sebastianbeyer/KOSMO_haltingproblem/KosmoTuringJack/TuringJack.kicad_pcb

## KiCad design KosmoTuringJack/TuringJack.kicad_pcb (2022-09-26)

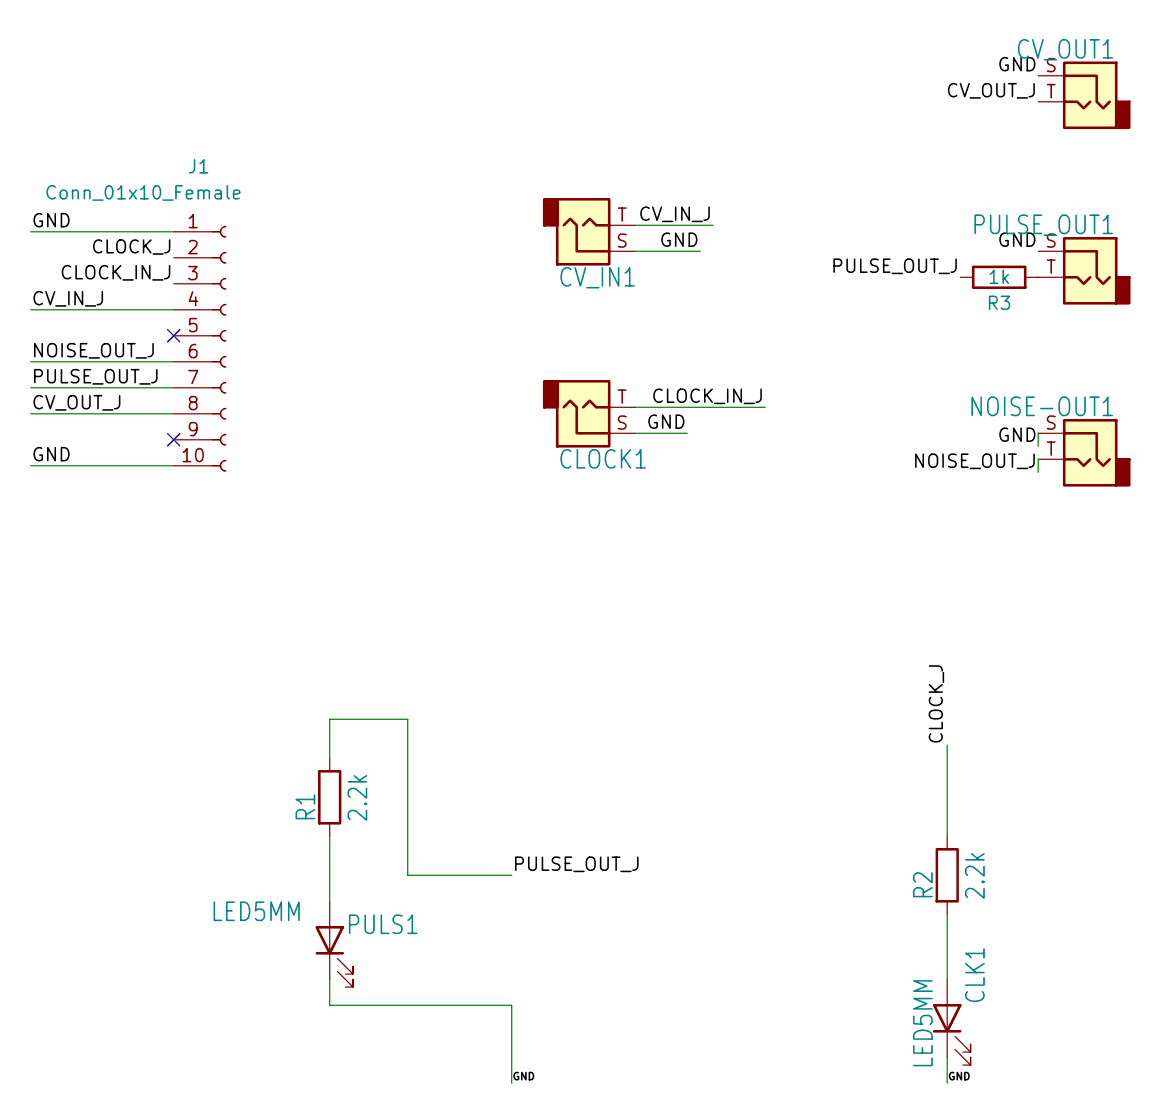
[picture p1: schematic TuringJack.kicad_sch]

Parts:
CLK1: LED5MM; LED_D5.0mm
CLOCK1: THONKICONNNEW; Jack_6.35mm_PJ_629HAN
CV_IN1: THONKICONNNEW; Jack_6.35mm_PJ_629HAN
CV_OUT1: THONKICONNNEW; Jack_6.35mm_PJ_629HAN
J1: Conn_01x10_Female; PinSocket_1x10_P2.54mm_Vertical
NOISE-OUT1: THONKICONNNEW; Jack_6.35mm_PJ_629HAN
PULS1: LED5MM; LED_D5.0mm
PULSE_OUT1: THONKICONNNEW; Jack_6.35mm_PJ_629HAN
R1, R2: 2.2k; R_Axial_DIN0207_L6.3mm_D2.5mm_P10.16mm_Horizontal
R3: 1k; R_Axial_DIN0207_L6.3mm_D2.5mm_P10.16mm_Horizontal

Connections:
/CLOCK_IN_J: CLOCK1.T, J1.3
/CLOCK_J: J1.2, R2.1
/CV_IN_J: CV_IN1.T, J1.4
/CV_OUT_J: CV_OUT1.T, J1.8
/GND: CLK1.1 (K), CLOCK1.S, CV_IN1.S, CV_OUT1.S, J1.1, J1.10, NOISE-OUT1.S, PULS1.1 (K), PULSE_OUT1.S
/NOISE_OUT_J: J1.6, NOISE-OUT1.T
/PULSE_OUT_J: J1.7, R1.1, R3.1
unnamed: CLK1.2 (A), R2.2
unnamed: PULS1.2 (A), R1.2
unnamed: PULSE_OUT1.T, R3.2

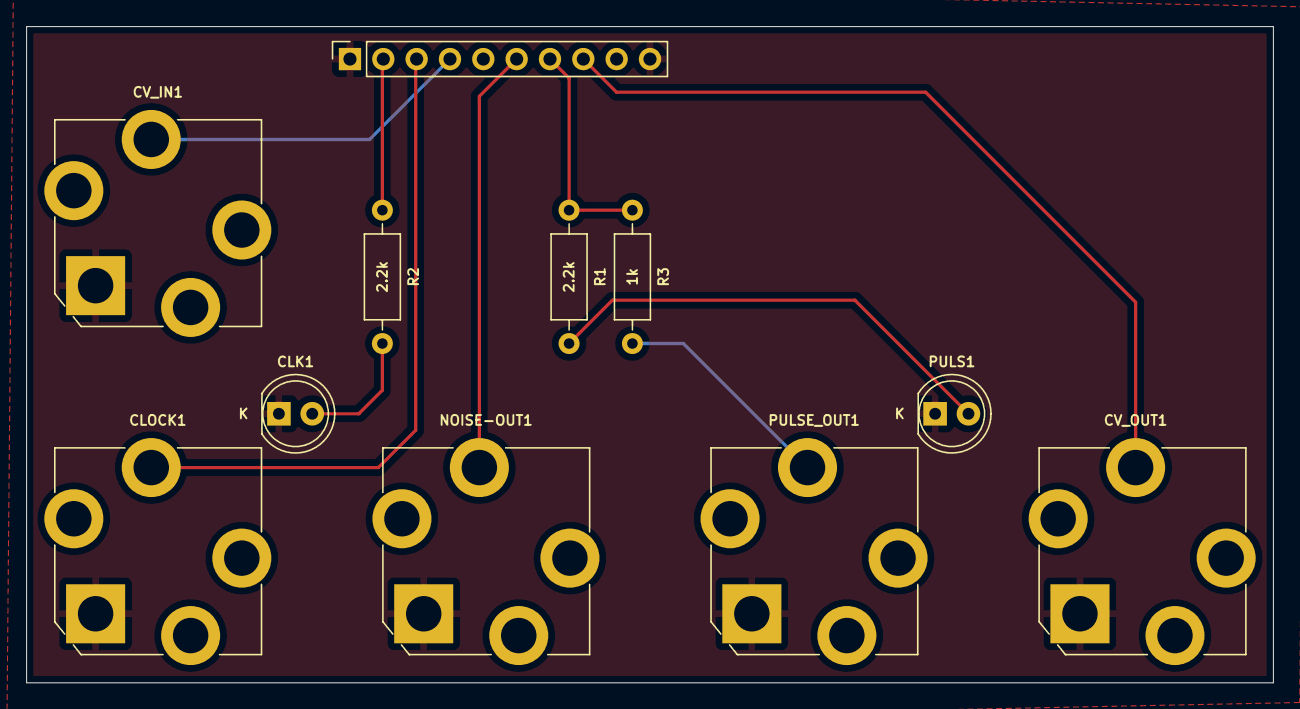
[picture p2: board TuringJack.kicad_pcb from above]

Board: 2 copper layers, 95.0 x 50.0 mm, 11 parts (0 on the bottom side), 10 nets.
