sebastianbeyer/KOSMO_haltingproblem/KosmoTuringMain/TuringMain.kicad_pcb

## KiCad design KosmoTuringMain/TuringMain.kicad_pcb (2022-09-26)

Schematic: TuringMain.kicad_sch

Parts:
AND_1, AND_2: 4081; DIL14
BUFFER1, BUFFER2: 4050; DIL16
C1, C5, C6, C7, C8, C13: 1n; C050-024X044
C2: 10n; C050-024X044
C3, C4, C15, C16, C17, C18, C19, C20, C21, C23, C24, C25, C26: 100n; C_Disc_D3.0mm_W1.6mm_P2.50mm
C9, C10, C12: 0.47uf; C050-035X075
C11: 330pf; C050-024X044
C14: 100n; C050-024X044
C22, C27: 10uf; CP_Radial_D6.3mm_P2.50mm
CHANGE1: 50k; Potentiometer_Alpha_RD901F-40-00D_Single_Vertical_centered
CLOCK1: THONKICONNNEW; Jack_6.35mm_PJ_629HAN
CV_IN1: THONKICONNNEW; Jack_6.35mm_PJ_629HAN
CV_OUT1: THONKICONNNEW; Jack_6.35mm_PJ_629HAN
D1: 1N4148; DO35-7
GATES1: MA08-2; IDC-Header_2x08_P2.54mm_Vertical
IC1: TL072P; DIL08
IC2, IC3: 78L09; TO-92_Inline_Wide
J1: Conn_01x10_Female; PinSocket_1x10_P2.54mm_Vertical
J2: Conn_01x10_Male; PinHeader_1x10_P2.54mm_Vertical
L1, L2: BL01RN1A
LENGTH1: ALPS-SRBV
NOISE-OUT1: THONKICONNNEW; Jack_6.35mm_PJ_629HAN
PULSES1: MA08-2; IDC-Header_2x08_P2.54mm_Vertical
PULSE_OUT1: THONKICONNNEW; Jack_6.35mm_PJ_629HAN
R1, R6, R7, R8, R12, R13, R14, R17, R23, R27: 10k; R_Axial_DIN0207_L6.3mm_D2.5mm_P10.16mm_Horizontal
R2: 3.3k; R_Axial_DIN0207_L6.3mm_D2.5mm_P10.16mm_Horizontal
R3, R5, R21, R24, R25: 100k; R_Axial_DIN0207_L6.3mm_D2.5mm_P10.16mm_Horizontal
R4, R9: 1.6k; R_Axial_DIN0207_L6.3mm_D2.5mm_P10.16mm_Horizontal
R10: 51k; R_Axial_DIN0207_L6.3mm_D2.5mm_P10.16mm_Horizontal
R11: 47k; R_Axial_DIN0207_L6.3mm_D2.5mm_P10.16mm_Horizontal
R15, R22, R26, R30: 1k; R_Axial_DIN0207_L6.3mm_D2.5mm_P10.16mm_Horizontal
R16: 5.1k; R_Axial_DIN0207_L6.3mm_D2.5mm_P10.16mm_Horizontal
R18: 68k; R_Axial_DIN0207_L6.3mm_D2.5mm_P10.16mm_Horizontal
R19, R29: 470k; R_Axial_DIN0207_L6.3mm_D2.5mm_P10.16mm_Horizontal
R20, R28: 15k; R_Axial_DIN0207_L6.3mm_D2.5mm_P10.16mm_Horizontal
R31, R32, R33, R34, R35, R36, R37, R38: 2.2k; R_Axial_DIN0207_L6.3mm_D2.5mm_P10.16mm_Horizontal
SCALE1: 50k; Potentiometer_Alpha_RD901F-40-00D_Single_Vertical_centered
SHIFTREG_EXT1: 4015; DIL16
SHIFTREG_MAIN1: 4015; DIL16
SV1: 10_PIN_HEADER; Power_Header
SWITCH_IC1: 4016; DIL14
T1: 2N3904; TO-92_Inline_Wide
TL1: TL431CLP; TO-92_Inline_Wide
U1: TL074_; DIL14
U$1: DAC0800; DIL16
UNK1, UNK2, UNK3, UNK4, UNK5, UNK6, UNK7, UNK8: LED5MM; LED_D5.0mm
VR1: 1M; Potentiometer_Bourns_3296W_Vertical_screw_centered
WRITE1: T-80-T-SPDT-ON-OFF-ON; SPDT-toggle-switch-1M-series

Connections:
/+12V: AND_1.14 (VDD), AND_2.14 (VDD), C3.2, C15.2, C16.1, C17.1, C18.1, C19.1, C20.1, C21.2, C22.1, GATES1.15, GATES1.16, IC1.8 (V+), IC2.3 (VI), IC3.3 (VI), L1.2, PULSES1.15, PULSES1.16, R1.2, R2.1, R7.2, R12.2, R18.1, R21.1, SHIFTREG_EXT1.16 (VDD), SHIFTREG_MAIN1.16 (VDD), SWITCH_IC1.14 (VDD), U1.4 (V+), U$1.13 (V+), WRITE1.1 (O)
/+12V_INLET: L1.1, SV1.9 (+12V), SV1.10 (+12V)
/-12V: C2.2, C4.2, C25.1, C26.2, C27.2, GATES1.11, GATES1.12, IC1.4 (V-), L2.2, PULSES1.11, PULSES1.12, R6.2, U1.11 (V-), U$1.3 (V-)
/-12V_INLET: L2.1, SV1.1 (-12V), SV1.2 (-12V)
/B1: AND_1.1 (I0), BUFFER1.9 (I), LENGTH1.F (6), R14.1, SHIFTREG_MAIN1.2 (QD), U$1.5 (B1-MSB), UNK8.2 (A)
/B2: AND_1.12 (I0), BUFFER1.11 (I), SHIFTREG_MAIN1.11 (QC), U$1.6 (B2), UNK4.2 (A)
/B3: AND_1.5 (I0), BUFFER1.7 (I), LENGTH1.E (5), SHIFTREG_MAIN1.12 (QB), U$1.7 (B3), UNK7.2 (A)
/B4: AND_1.8 (I0), BUFFER1.5 (I), LENGTH1.D (4), SHIFTREG_MAIN1.13 (QA), U$1.8 (B4), UNK3.2 (A)
/B5: AND_2.12 (I0), BUFFER2.11 (I), LENGTH1.C (3), R8.1, SHIFTREG_MAIN1.10 (QD), U$1.9 (B5), UNK6.2 (A)
/B6: AND_2.8 (I0), BUFFER2.9 (I), LENGTH1.B (2), SHIFTREG_MAIN1.3 (QC), U$1.10 (B6), UNK2.2 (A)
/B7: AND_2.5 (I0), BUFFER2.7 (I), LENGTH1.A (1), SHIFTREG_MAIN1.4 (QB), U$1.11 (B7), UNK5.2 (A)
/B8: AND_2.1 (I0), BUFFER2.5 (I), SHIFTREG_MAIN1.5 (QA), U$1.12 (B8-LSB), UNK1.2 (A)
/BUFFCLK: AND_1.2 (I1), AND_1.6 (I1), AND_1.9 (I1), AND_1.13 (I1), BUFFER2.2 (O), PULSES1.9, PULSES1.10
/BUFFCLK2: AND_2.2 (I1), AND_2.6 (I1), AND_2.9 (I1), AND_2.13 (I1), BUFFER1.2 (O), GATES1.9, GATES1.10
/CLOCK: BUFFER1.3 (I), BUFFER2.3 (I), D1.C, J2.2, R19.1, R27.1, SHIFTREG_EXT1.1 (CLK), SHIFTREG_EXT1.9 (CLK), SHIFTREG_MAIN1.1 (CLK), SHIFTREG_MAIN1.9 (CLK)
/CLOCK_IN: J2.3, R20.1
/CV_IN: J2.4, R10.1
/CV_OUT: CV_OUT1.T, J2.8, R15.1
/END_OF_LOOP: LENGTH1.COM (A), LENGTH1.COM2 (A), SWITCH_IC1.1 (A), SWITCH_IC1.5 (C)
/GATE1: BUFFER2.4 (O), GATES1.1
/GATE2: BUFFER2.6 (O), GATES1.2
/GATE3: BUFFER2.10 (O), GATES1.3
/GATE4: BUFFER2.12 (O), GATES1.4
/GATE5: BUFFER1.4 (O), GATES1.5
/GATE6: BUFFER1.6 (O), GATES1.6
/GATE7: BUFFER1.12 (O), GATES1.7
/GATE8: BUFFER1.10 (O), GATES1.8
/LOOP_CTRL: IC1.2 (-IN), R3.2, R10.2, R11.1
/NOISE: C9.2, IC1.5 (+IN), R24.2, R26.2
/NOISE_OUT: J2.6, R26.1
/PULSE1: AND_2.3 (O), BUFFER1.14 (I), PULSES1.1
/PULSE2: AND_2.4 (O), PULSES1.2
/PULSE3: AND_2.10 (O), PULSES1.3
/PULSE4: AND_2.11 (O), PULSES1.4
/PULSE5: AND_1.10 (O), PULSES1.5
/PULSE6: AND_1.4 (O), PULSES1.6
/PULSE7: AND_1.11 (O), PULSES1.7
/PULSE8: AND_1.3 (O), PULSES1.8
/PULSE_OUT: BUFFER1.15 (O), J2.7
/START_OF_LOOP: C5.2, R13.1, R30.2, SHIFTREG_MAIN1.7 (D)
/STEP_12: C8.2, LENGTH1.G (7), R17.2, SHIFTREG_EXT1.15 (D)
/STEP_16: LENGTH1.H (8), SHIFTREG_EXT1.2 (QD)
GND: AND_1.7 (VSS), AND_2.7 (VSS), BUFFER1.8 (VSS), BUFFER2.8 (VSS), BUFFER2.14 (I), C1.1, C3.1, C4.1, C5.1, C6.1, C8.1, C11.1, C14.1, C15.1, C16.2, C17.2, C18.2, C19.2, C20.2, C21.1, C22.2, C23.1, C24.1, C25.2, C26.1, C27.1, CLOCK1.S, CV_IN1.S, CV_OUT1.S, GATES1.13, GATES1.14, IC1.3 (+IN), IC2.2 (GND), IC3.2 (GND), J1.1, J1.10, J2.1, J2.10, NOISE-OUT1.S, PULSES1.13, PULSES1.14, PULSE_OUT1.S, R9.1, R24.1, R25.1, R27.2, R28.1, R31.2, R32.2, R33.2, R34.2, R35.1, R36.1, R37.1, R38.1, SCALE1.1, SHIFTREG_EXT1.6 (RES), SHIFTREG_EXT1.8 (VSS), SHIFTREG_EXT1.14 (RES), SHIFTREG_MAIN1.6 (RES), SHIFTREG_MAIN1.8 (VSS), SHIFTREG_MAIN1.14 (RES), SV1.3 (GND), SV1.4 (GND), SV1.5 (GND), SV1.6 (GND), SV1.7 (GND), SV1.8 (GND), SWITCH_IC1.3 (B), SWITCH_IC1.7 (VSS), SWITCH_IC1.9 (B), T1.2 (B), TL1.2 (A), U1.3 (+IN), U1.10 (+IN), U1.12 (+IN), U$1.1 (VLC), U$1.2 (IOUT), WRITE1.3 (S)
unnamed: BUFFER1.1 (VDD), C23.2, IC2.1 (VO)
unnamed: BUFFER2.1 (VDD), C24.2, IC3.1 (VO)
unnamed: C1.2, R8.2, SHIFTREG_MAIN1.15 (D)
unnamed: C2.1, U$1.16 (COMP)
unnamed: C6.2, R14.2, SHIFTREG_EXT1.7 (D)
unnamed: C7.1, R16.1, U1.2 (-IN), U$1.4 (IOUTB)
unnamed: C7.2, R16.2, SCALE1.3, U1.1 (OUT)
unnamed: C10.1, R29.1, U1.8 (OUT)
unnamed: C10.2, R22.2
unnamed: C11.2, R19.2, R20.2, R25.2, U1.5 (+IN)
unnamed: C12.1, R23.1
unnamed: C12.2, R21.2, T1.1 (E)
unnamed: C13.1, R22.1, U1.13 (-IN), VR1.1
unnamed: C9.1, C13.2, U1.14 (OUT), VR1.2, VR1.3
unnamed: C14.2, R18.2, R28.2, U1.6 (-IN)
unnamed: CHANGE1.1, R6.1
unnamed: CHANGE1.2, R3.1
unnamed: CHANGE1.3, R1.1
unnamed: CLOCK1.T, J1.3
unnamed: CV_IN1.T, J1.4
unnamed: D1.A, U1.7 (OUT)
unnamed: IC1.1 (OUT), IC1.6 (-IN), R11.2
unnamed: IC1.7 (OUT), R5.2
unnamed: J1.6, NOISE-OUT1.T
unnamed: J1.7, PULSE_OUT1.T
unnamed: R2.2, R4.2, TL1.1 (REF), TL1.3 (K)
unnamed: R4.1, U$1.14 (VREF+)
unnamed: R5.1, SWITCH_IC1.6 (C), SWITCH_IC1.13 (C)
unnamed: R7.1, SWITCH_IC1.4 (A), SWITCH_IC1.11 (A)
unnamed: R9.2, U$1.15 (VREF-)
unnamed: R12.1, SWITCH_IC1.8 (A), SWITCH_IC1.12 (C)
unnamed: R13.2, SWITCH_IC1.2 (B), SWITCH_IC1.10 (B)
unnamed: R15.2, SCALE1.2
unnamed: R17.1, SHIFTREG_EXT1.10 (QD)
unnamed: R23.2, R29.2, U1.9 (-IN)
unnamed: R30.1, WRITE1.2
unnamed: R31.1, UNK1.1 (K)
unnamed: R32.1, UNK5.1 (K)
unnamed: R33.1, UNK2.1 (K)
unnamed: R34.1, UNK6.1 (K)
unnamed: R35.2, UNK3.1 (K)
unnamed: R36.2, UNK7.1 (K)
unnamed: R37.2, UNK4.1 (K)
unnamed: R38.2, UNK8.1 (K)

Notes on the sheet:
Shift register loop
Length steps: 16 = step_16 12 = step_12 8 = B1 6 = B3 5 = B4 4 = B5 3 = B6 2 = B7
Randomised invert/loop switching
/Users/aash/Dropbox/Electronics/~{MODULAR/design/logo} copy.bmp
DAC
NB: Bit numbers are reversed at this point: Bit8 = first bit (left hand LED on main module) becomes Pulse1 (Top output on expanders)
Clock input
Noise Generator

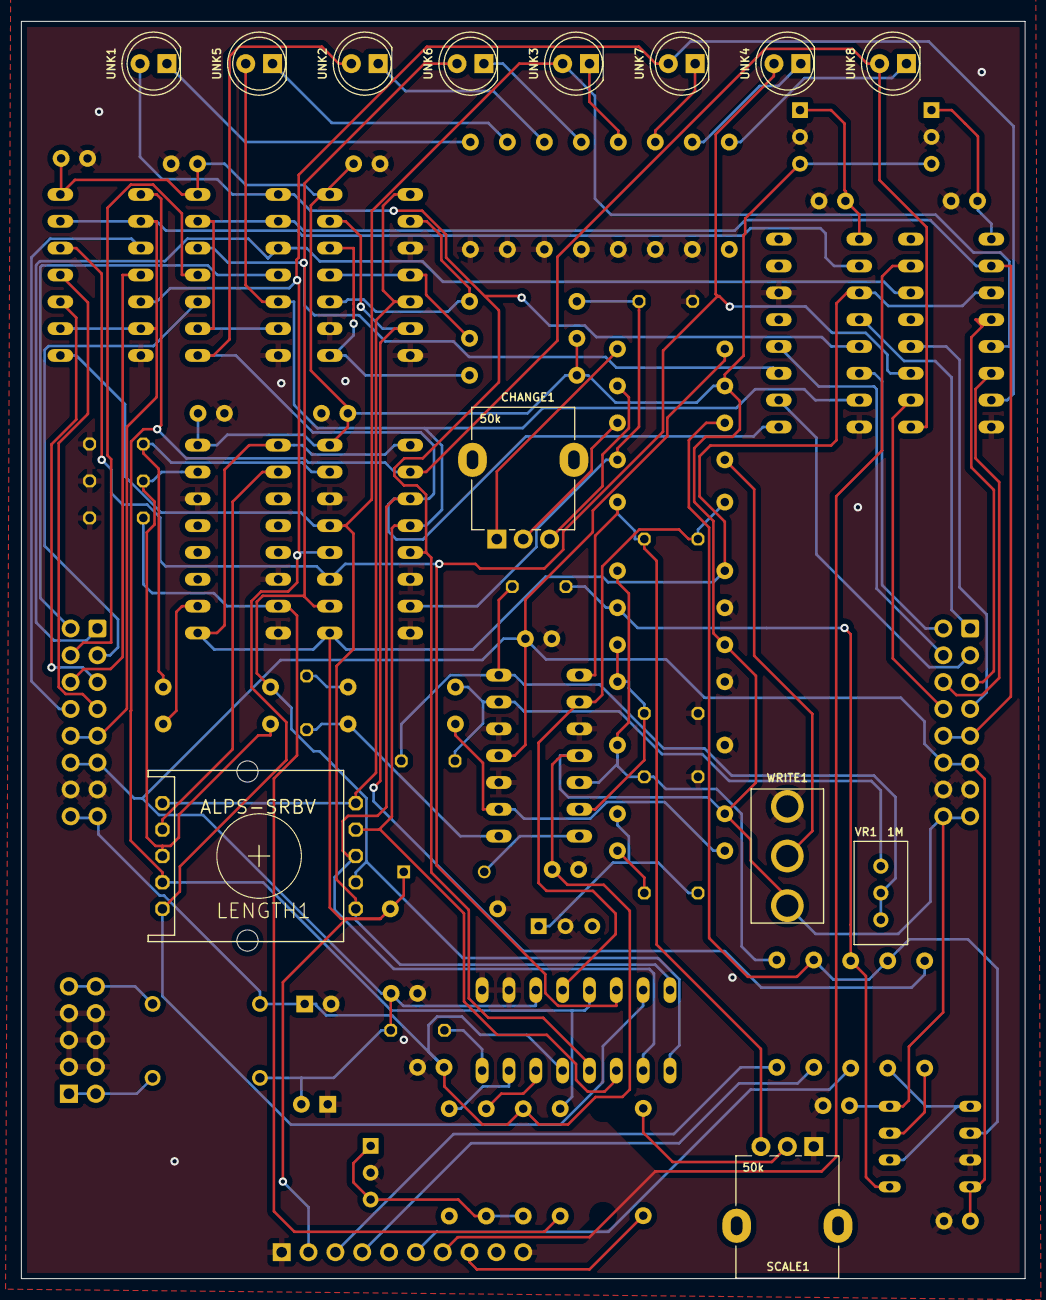
[picture p3: board TuringMain.kicad_pcb from above]

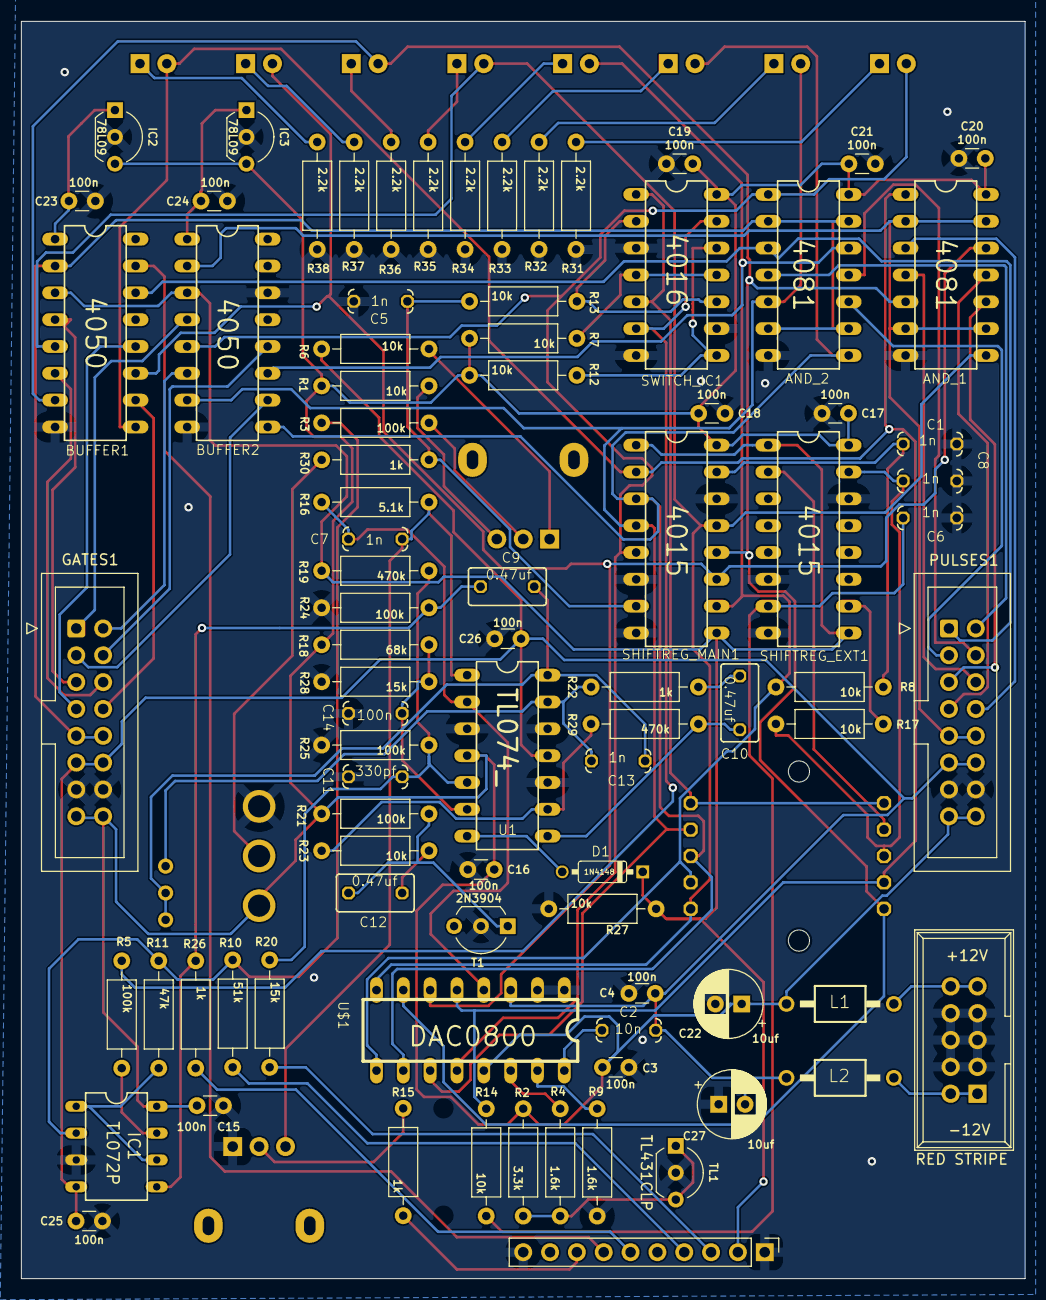
[picture p4: board TuringMain.kicad_pcb from below]

Board: 2 copper layers, 95.0 x 119.0 mm, 99 parts (86 on the bottom side), 83 nets.
