sebastianbeyer/KOSMO_haltingproblem/KosmoPulseMain/KosmoPulseMain.kicad_pcb

## KiCad design KosmoPulseMain/KosmoPulseMain.kicad_pcb (2022-09-13)

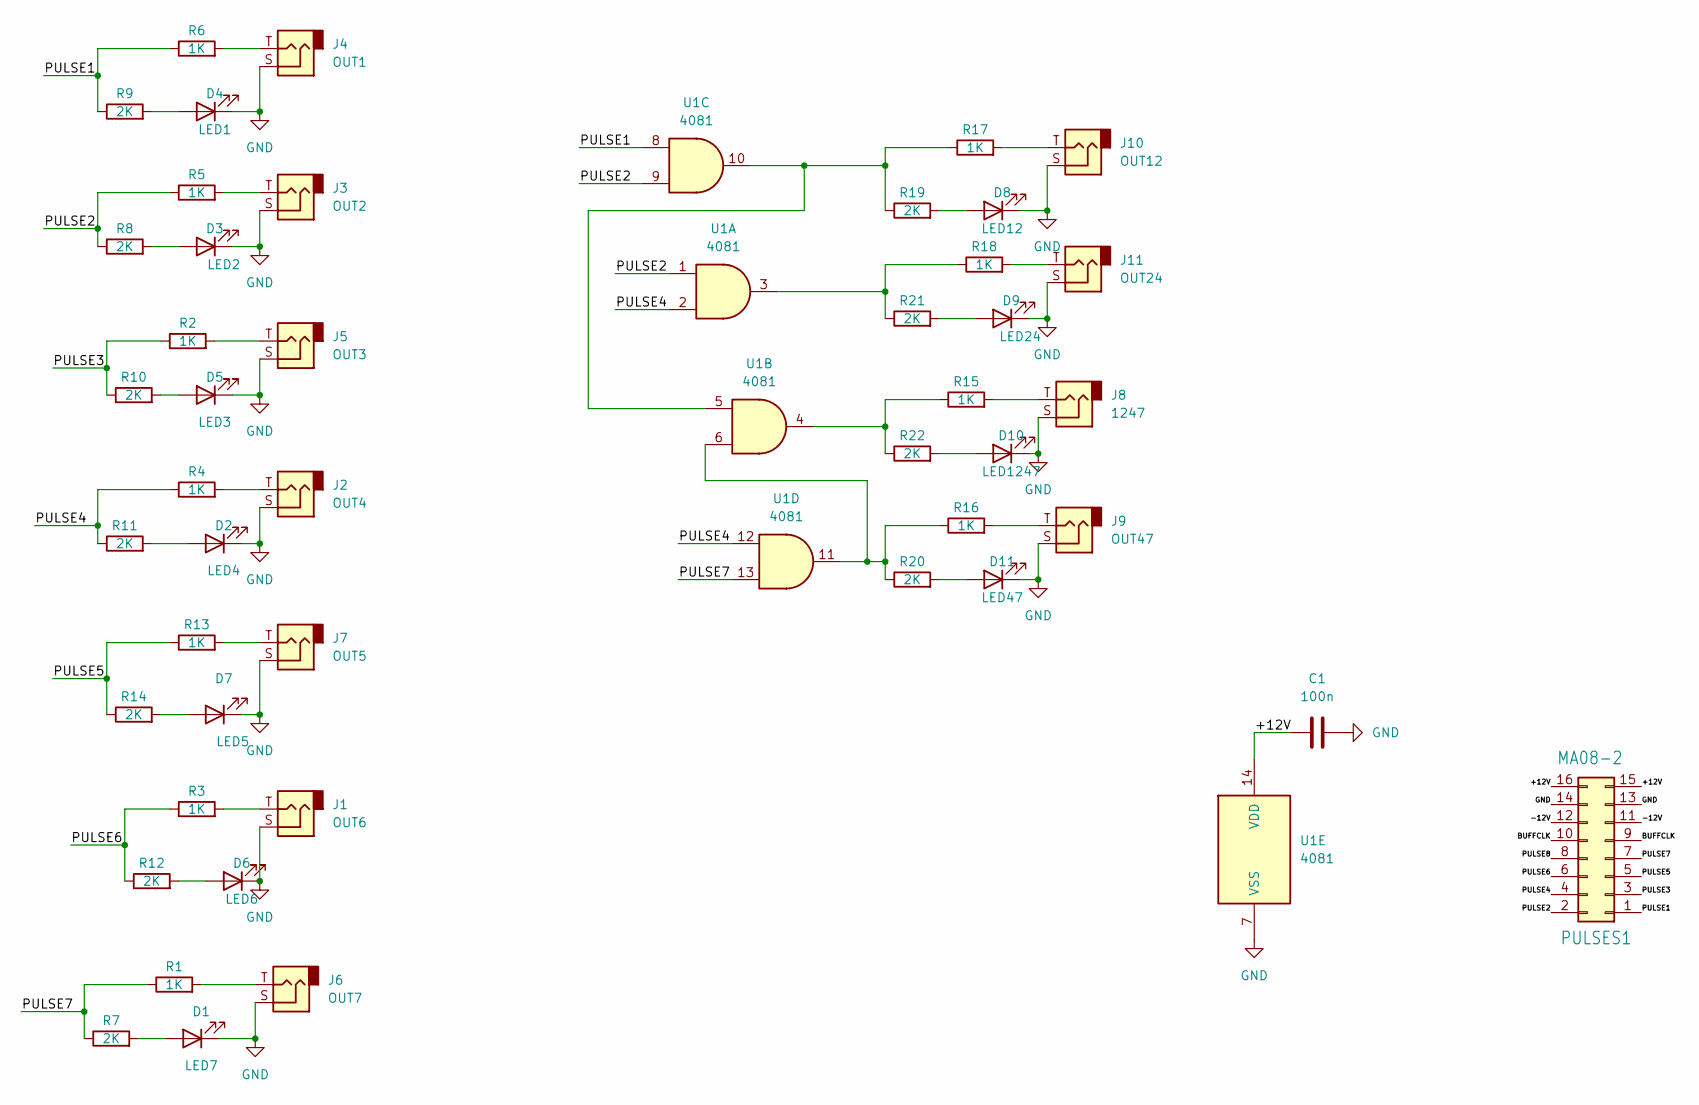
[picture p5: schematic KosmoPulseMain.kicad_sch]

Parts:
C1: 100n; C_Disc_D3.0mm_W1.6mm_P2.50mm
D1: LED7; LED_D5.0mm
D2: LED4; LED_D5.0mm
D3: LED2; LED_D5.0mm
D4: LED1; LED_D5.0mm
D5: LED3; LED_D5.0mm
D6: LED6; LED_D5.0mm
D7: LED5; LED_D5.0mm
D8: LED12; LED_D5.0mm
D9: LED24; LED_D5.0mm
D10: LED1247; LED_D5.0mm
D11: LED47; LED_D5.0mm
J1: OUT6; Jack_6.35mm_PJ_629HAN
J2: OUT4; Jack_6.35mm_PJ_629HAN
J3: OUT2; Jack_6.35mm_PJ_629HAN
J4: OUT1; Jack_6.35mm_PJ_629HAN
J5: OUT3; Jack_6.35mm_PJ_629HAN
J6: OUT7; Jack_6.35mm_PJ_629HAN
J7: OUT5; Jack_6.35mm_PJ_629HAN
J8: 1247; Jack_6.35mm_PJ_629HAN
J9: OUT47; Jack_6.35mm_PJ_629HAN
J10: OUT12; Jack_6.35mm_PJ_629HAN
J11: OUT24; Jack_6.35mm_PJ_629HAN
PULSES1: MA08-2; IDC-Header_2x08_P2.54mm_Vertical
R1, R2, R3, R4, R5, R6, R13, R15, R16, R17, R18: 1K; R_Axial_DIN0207_L6.3mm_D2.5mm_P2.54mm_Vertical
R7, R8, R9, R10, R11, R12, R14, R19, R20, R21, R22: 2K; R_Axial_DIN0207_L6.3mm_D2.5mm_P10.16mm_Horizontal
U1: 4081; DIP-14_W7.62mm_Socket_LongPads

Connections:
/+12V: C1.1, PULSES1.15, PULSES1.16, U1.14 (VDD)
/-12V: PULSES1.11, PULSES1.12
/BUFFCLK: PULSES1.9, PULSES1.10
/PULSE1: PULSES1.1, R6.1, R9.1, U1.8
/PULSE2: PULSES1.2, R5.1, R8.1, U1.1, U1.9
/PULSE3: PULSES1.3, R2.1, R10.1
/PULSE4: PULSES1.4, R4.1, R11.1, U1.2, U1.12
/PULSE5: PULSES1.5, R13.1, R14.1
/PULSE6: PULSES1.6, R3.1, R12.1
/PULSE7: PULSES1.7, R1.1, R7.1, U1.13
/PULSE8: PULSES1.8
GND: C1.2, D1.1 (K), D2.1 (K), D3.1 (K), D4.1 (K), D5.1 (K), D6.1 (K), D7.1 (K), D8.1 (K), D9.1 (K), D10.1 (K), D11.1 (K), J1.S, J2.S, J3.S, J4.S, J5.S, J6.S, J7.S, J8.S, J9.S, J10.S, J11.S, PULSES1.13, PULSES1.14, U1.7 (VSS)
unnamed: D1.2 (A), R7.2
unnamed: D2.2 (A), R11.2
unnamed: D3.2 (A), R8.2
unnamed: D4.2 (A), R9.2
unnamed: D5.2 (A), R10.2
unnamed: D6.2 (A), R12.2
unnamed: D7.2 (A), R14.2
unnamed: D8.2 (A), R19.2
unnamed: D9.2 (A), R21.2
unnamed: D10.2 (A), R22.2
unnamed: D11.2 (A), R20.2
unnamed: J1.T, R3.2
unnamed: J2.T, R4.2
unnamed: J3.T, R5.2
unnamed: J4.T, R6.2
unnamed: J5.T, R2.2
unnamed: J6.T, R1.2
unnamed: J7.T, R13.2
unnamed: J8.T, R15.2
unnamed: J9.T, R16.2
unnamed: J10.T, R17.2
unnamed: J11.T, R18.2
unnamed: R15.1, R22.1, U1.4
unnamed: R16.1, R20.1, U1.6, U1.11
unnamed: R17.1, R19.1, U1.5, U1.10
unnamed: R18.1, R21.1, U1.3

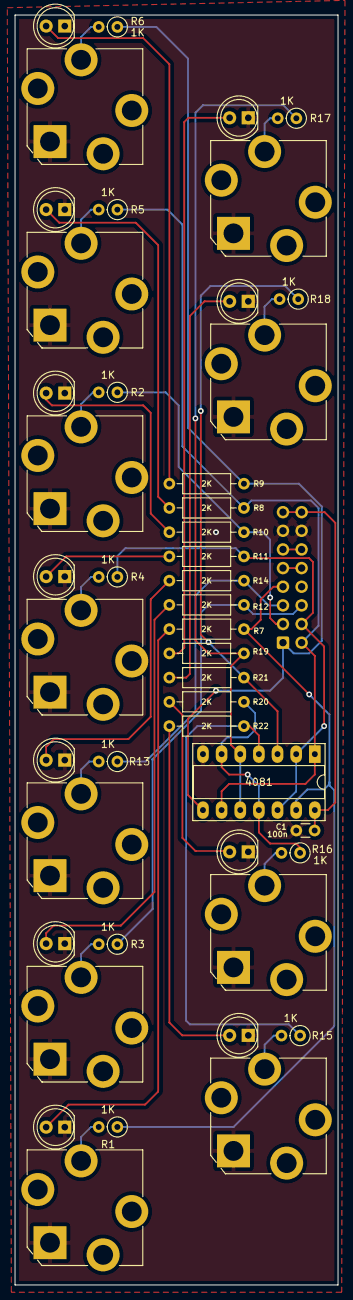
[picture p6: board KosmoPulseMain.kicad_pcb from above]

Board: 2 copper layers, 44.0 x 173.0 mm, 47 parts (1 on the bottom side), 37 nets.
