sebastianbeyer/KOSMO_haltingproblem/(commit log)

2022-09-13 add turing main panel
    [TuringPanel.kicad_pcb, TuringPanel.kicad_sch]
2022-09-13 add jack board
    [TuringJack.kicad_pcb, TuringJack.kicad_sch]
2022-09-13 add pulse addon board
    [KosmoPulseMain.kicad_pcb, KosmoPulseMain.kicad_sch, KosmoPulsePanel.kicad_pcb, KosmoPulsePanel.kicad_sch]
2022-09-23 fix #1 missing cathode connection of clock led
    [TuringJack.kicad_pcb, TuringJack.kicad_sch]
2022-09-26 move pulse out 1k resistor after the led, so it does not act as voltage divider, thanks @holmesrichards !
    [TuringJack.kicad_pcb, TuringJack.kicad_sch, TuringMain.kicad_pcb, TuringMain.kicad_sch]
2022-12-13 add BOM
