sebastianbeyer/KOSMO_haltingproblem/(notices)

Notices in the files:
KosmoTuringJack/TuringJack.kicad_pcb:
February 2016 CC-BY-SA
